ztc022/Positive-Voltage-Regulator-with-Built-in-Protection-/README.md

# Positive-Voltage-Regulator-with-Built-in-Protection-

The Draft1.asc file MUST be opened with LTSpice
