ztc022/Positive-Voltage-Regulator-with-Built-in-Protection-/Draft1.asc

D1: zener; BZX55C5V1
D2: diode; 1N4148
D3: diode; 1N4148
D4: zener; BZX55C2V7
D5: zener; BZX55C6V2
D6: zener; BZX55C8V2
D7: zener; BZX55C10
Q1: npn; BC546B
Q2: npn; BC546B
Q3: npn; BC546B
Q4: pnp; BC556B
Q5: pnp; BC556B
Q6: npn; BD241C
Q7: npn; BC546B
Q8: npn; BC546B
R1: res; 2k
R2: res; 2.7k
R3: res; 5.6k
R4: res; 150
R5: res; 1k
R6: res; 1k
R7: res; 10k
R8: res; 10k
R9: res; 6.8k
R11: res; 6.8k
R12: res; 22
R13: res; 100
R14: res; 9.1k
R15: res; 100
R16: res; 22
R17: res; 510
R18: res; 100
R19: res; 33
R100: res; 250
R101: res; 250
V1: voltage; 33
Named nets: 0
